thompsonjila/psoc_relocker/README.md

# psoc_relocker
PSoC-based PID Relocker with GUI
