thompsonjila/psoc_relocker/documentation/includes/relockerExtStructure.pdf

a) b)

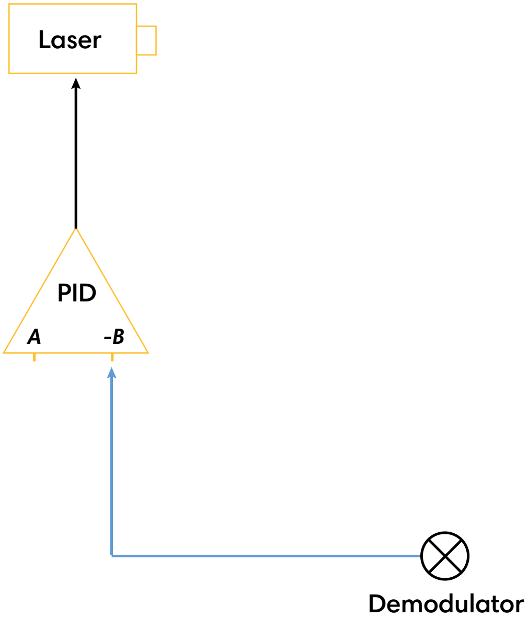
[picture p1: figure]
PID; Demodulator; Laser
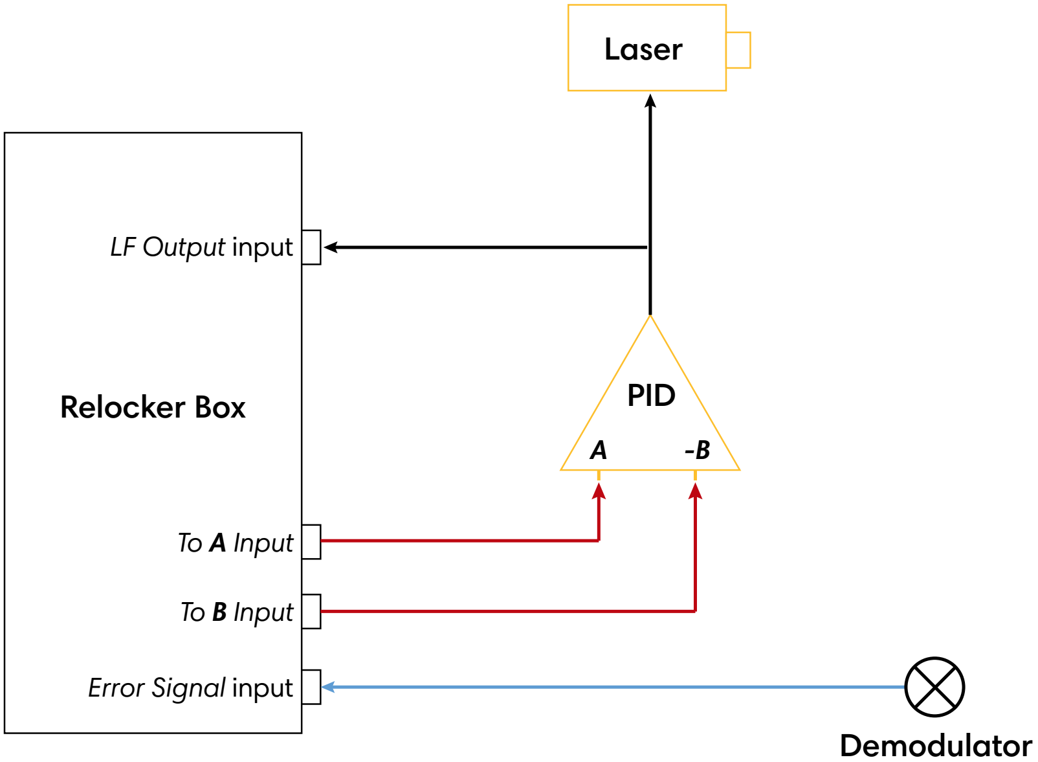
[picture p2: figure]
Error Signal input; To B Input; To A Input; LF Output input; Relocker Box; PID; Demodulator; Laser
