thompsonjila/psoc_relocker/documentation/includes/relockerSweepBoundCalculations.pdf

65535

-4 V | 0

255, 255

0, 0

4 V

Loop Filter Output Voltage | lfOutADC Parameters | DAC Parameters
