thompsonjila/psoc_relocker/documentation/includes/relockerBack.pdf

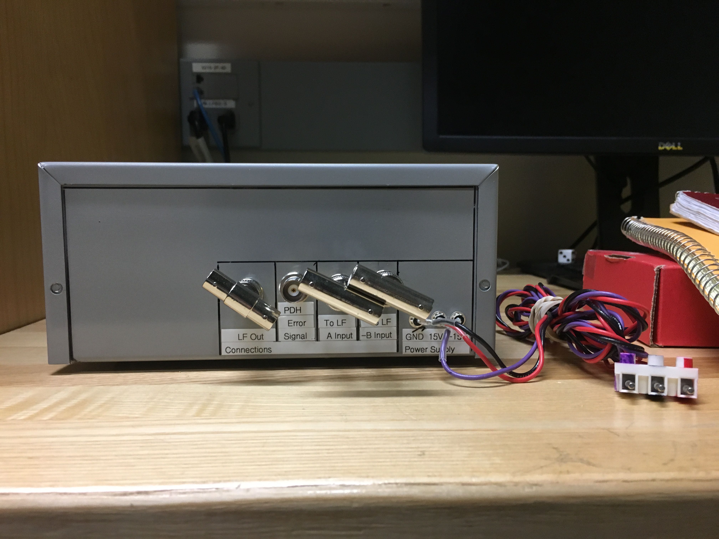
[picture p3: page 1]
