thompsonjila/psoc_relocker/documentation/includes/relockerFront.pdf

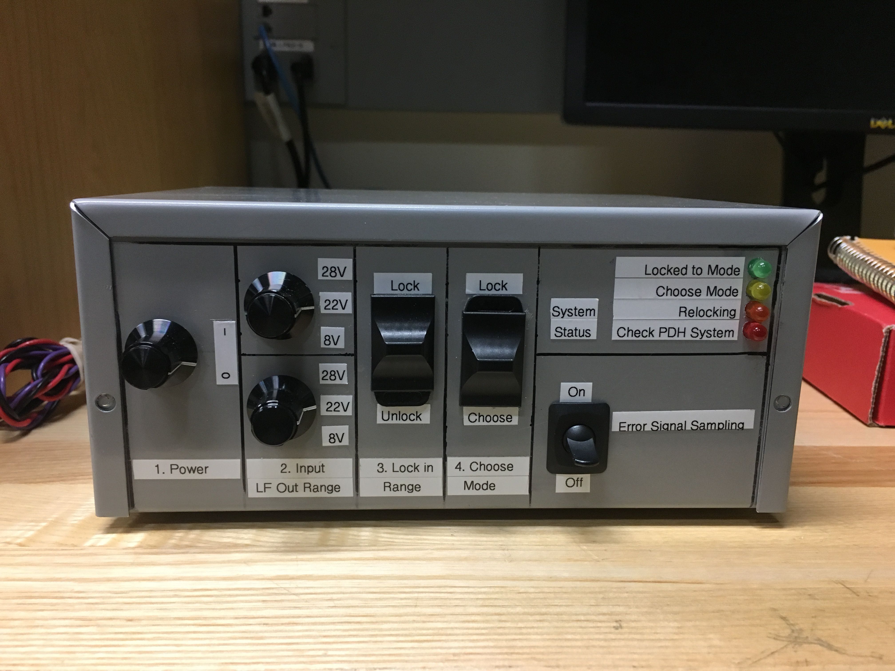
[picture p4: page 1]
