thompsonjila/psoc_relocker/documentation/includes/relockerInterior.pdf

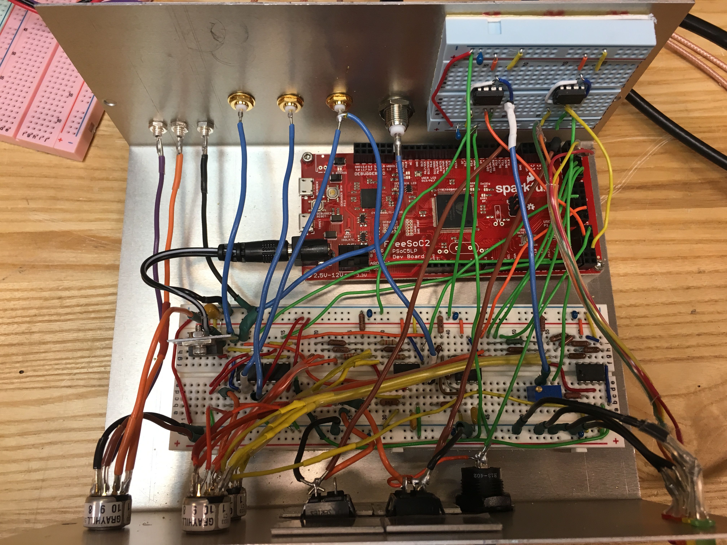
[picture p5: page 1]
