thompsonjila/psoc_relocker/documentation/includes/pinassignments.png

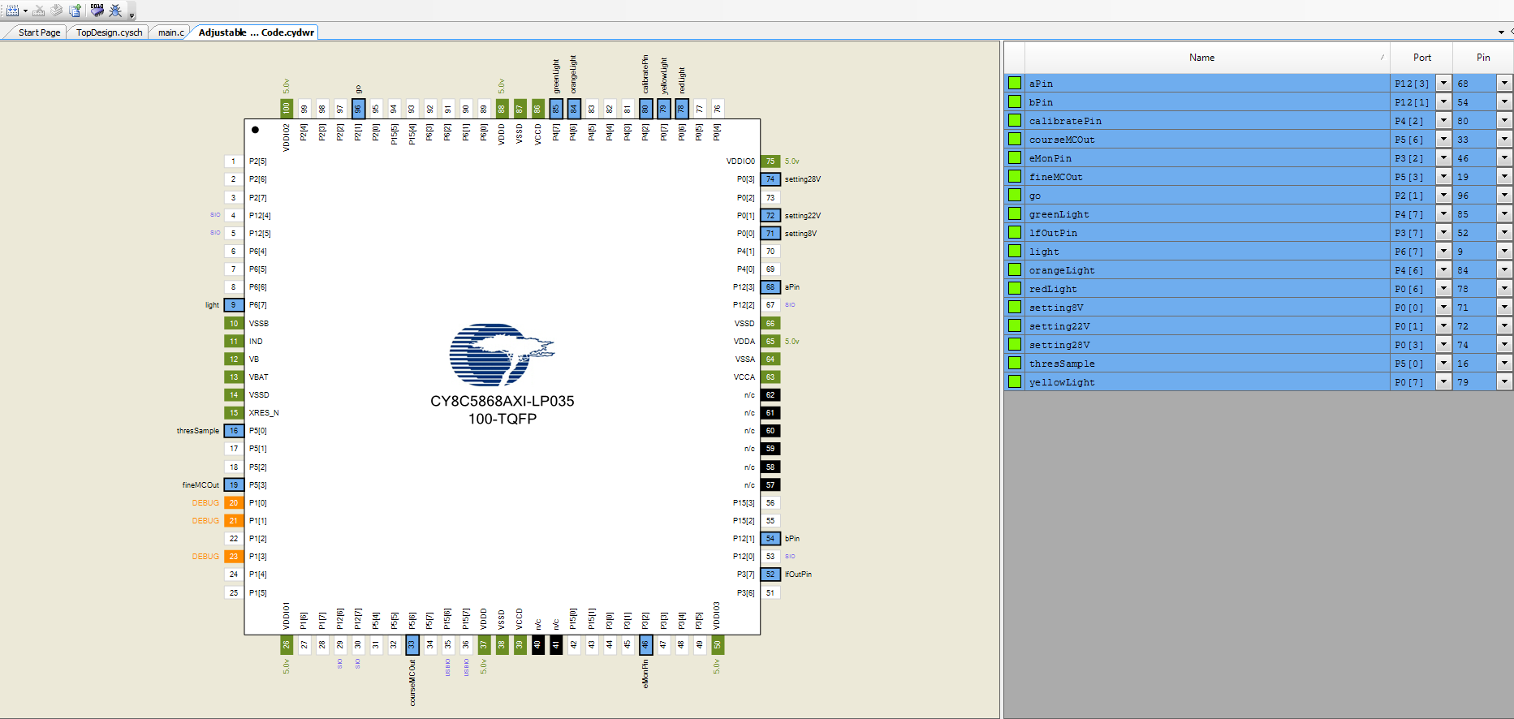
documentation/includes/pinassignments.png
