thompsonjila/psoc_relocker/documentation/includes/programmingIDE.png

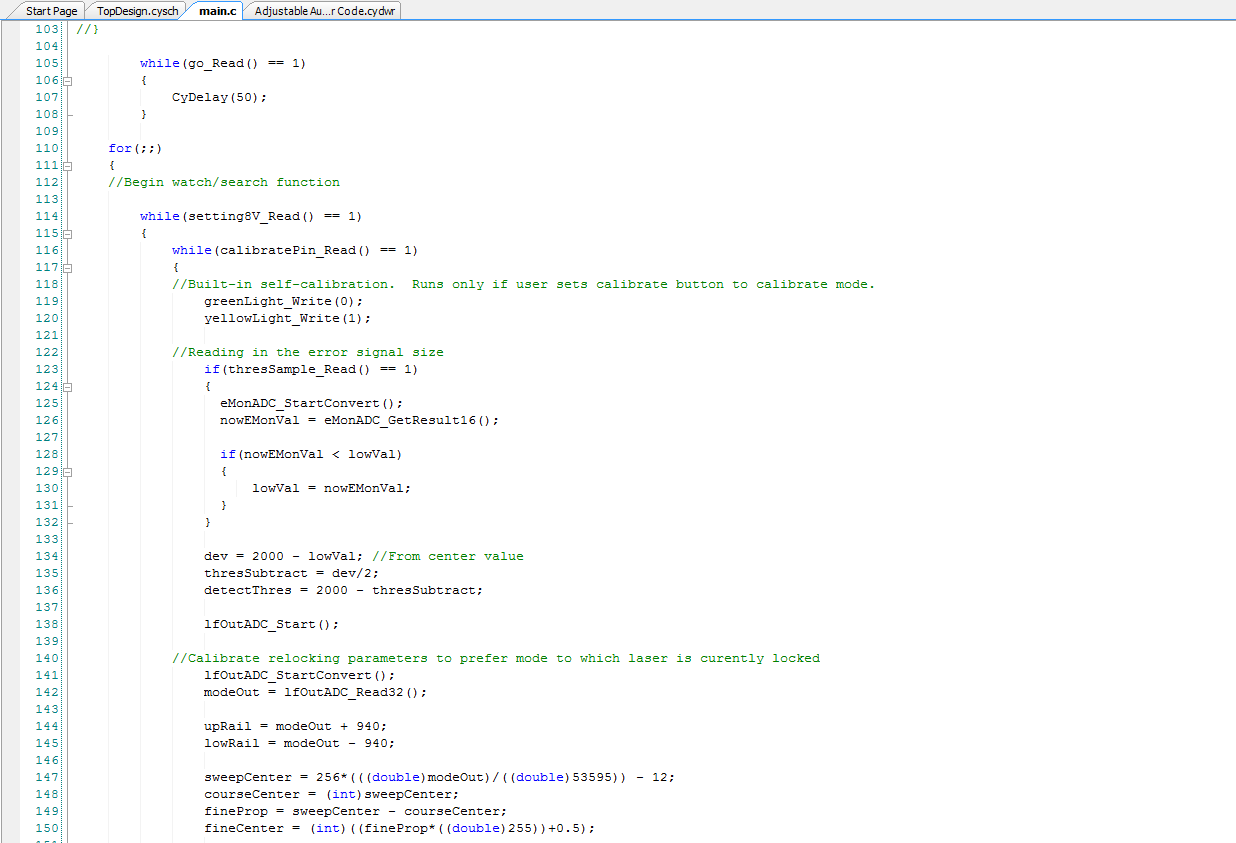
documentation/includes/programmingIDE.png
