thompsonjila/psoc_relocker/documentation/includes/relocker_circuits.png

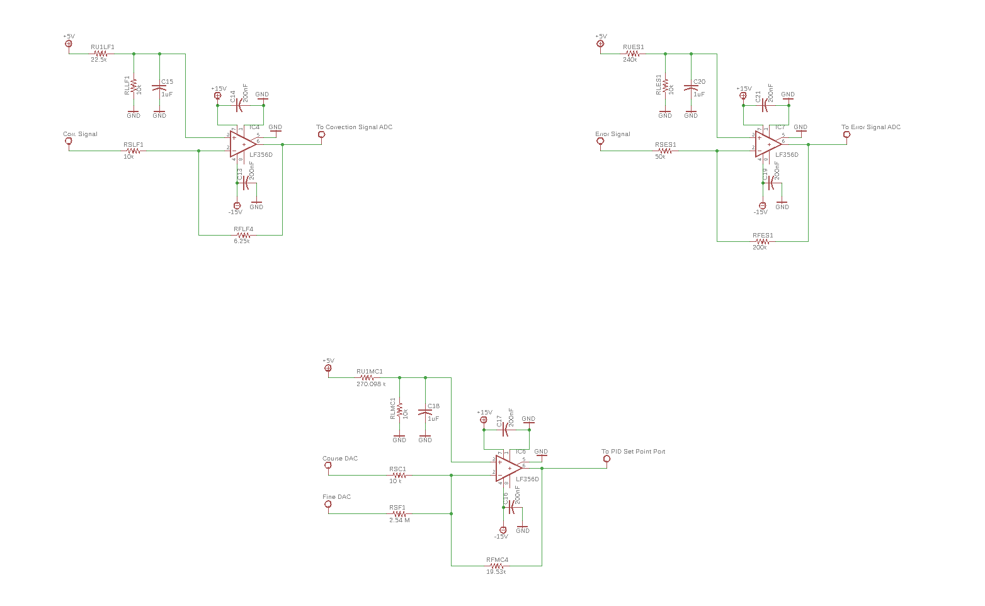
documentation/includes/relocker_circuits.png
