thompsonjila/psoc_relocker/documentation/includes/topdesign.png

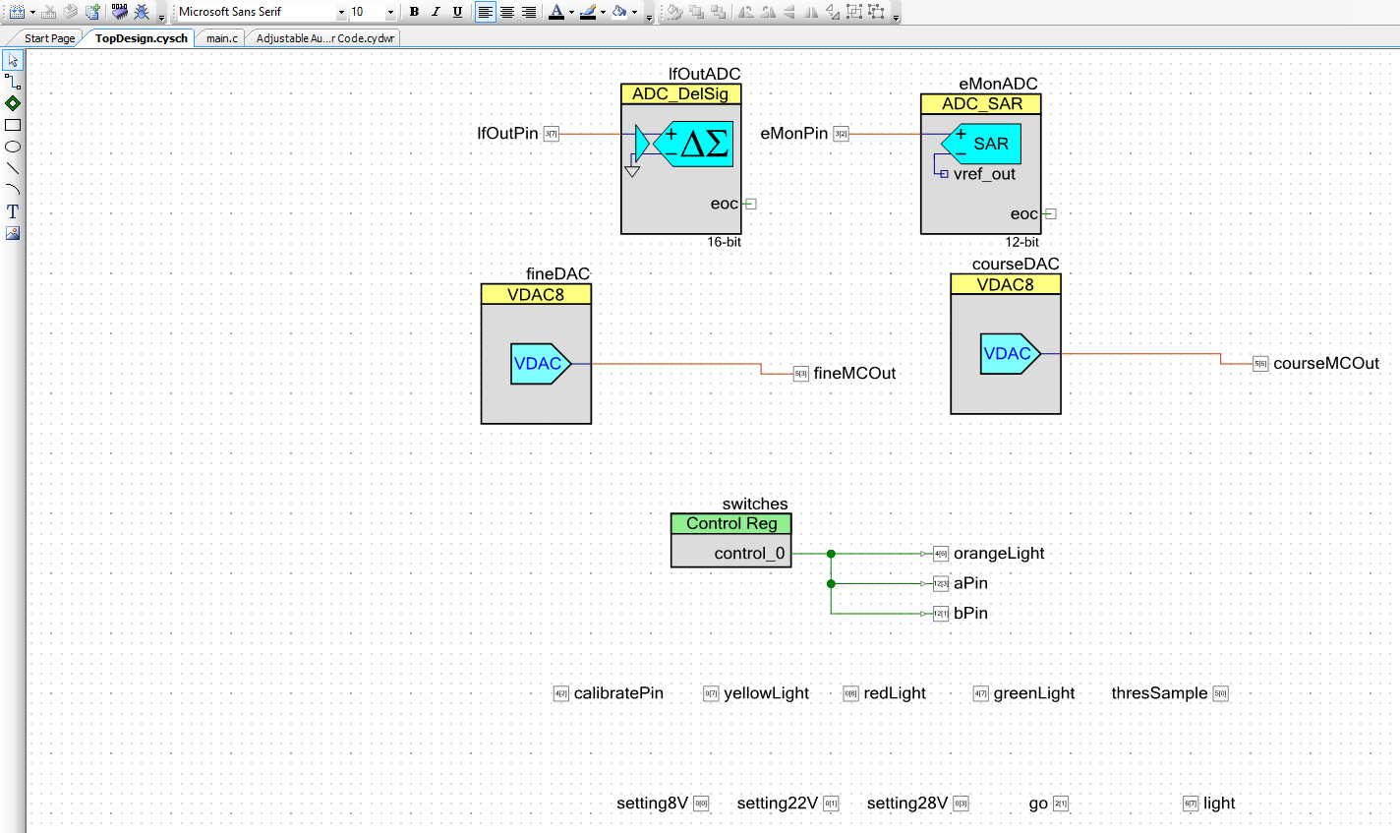
documentation/includes/topdesign.png
