thompsonjila/psoc_relocker/documentation/includes/relockerIntStructure.pdf

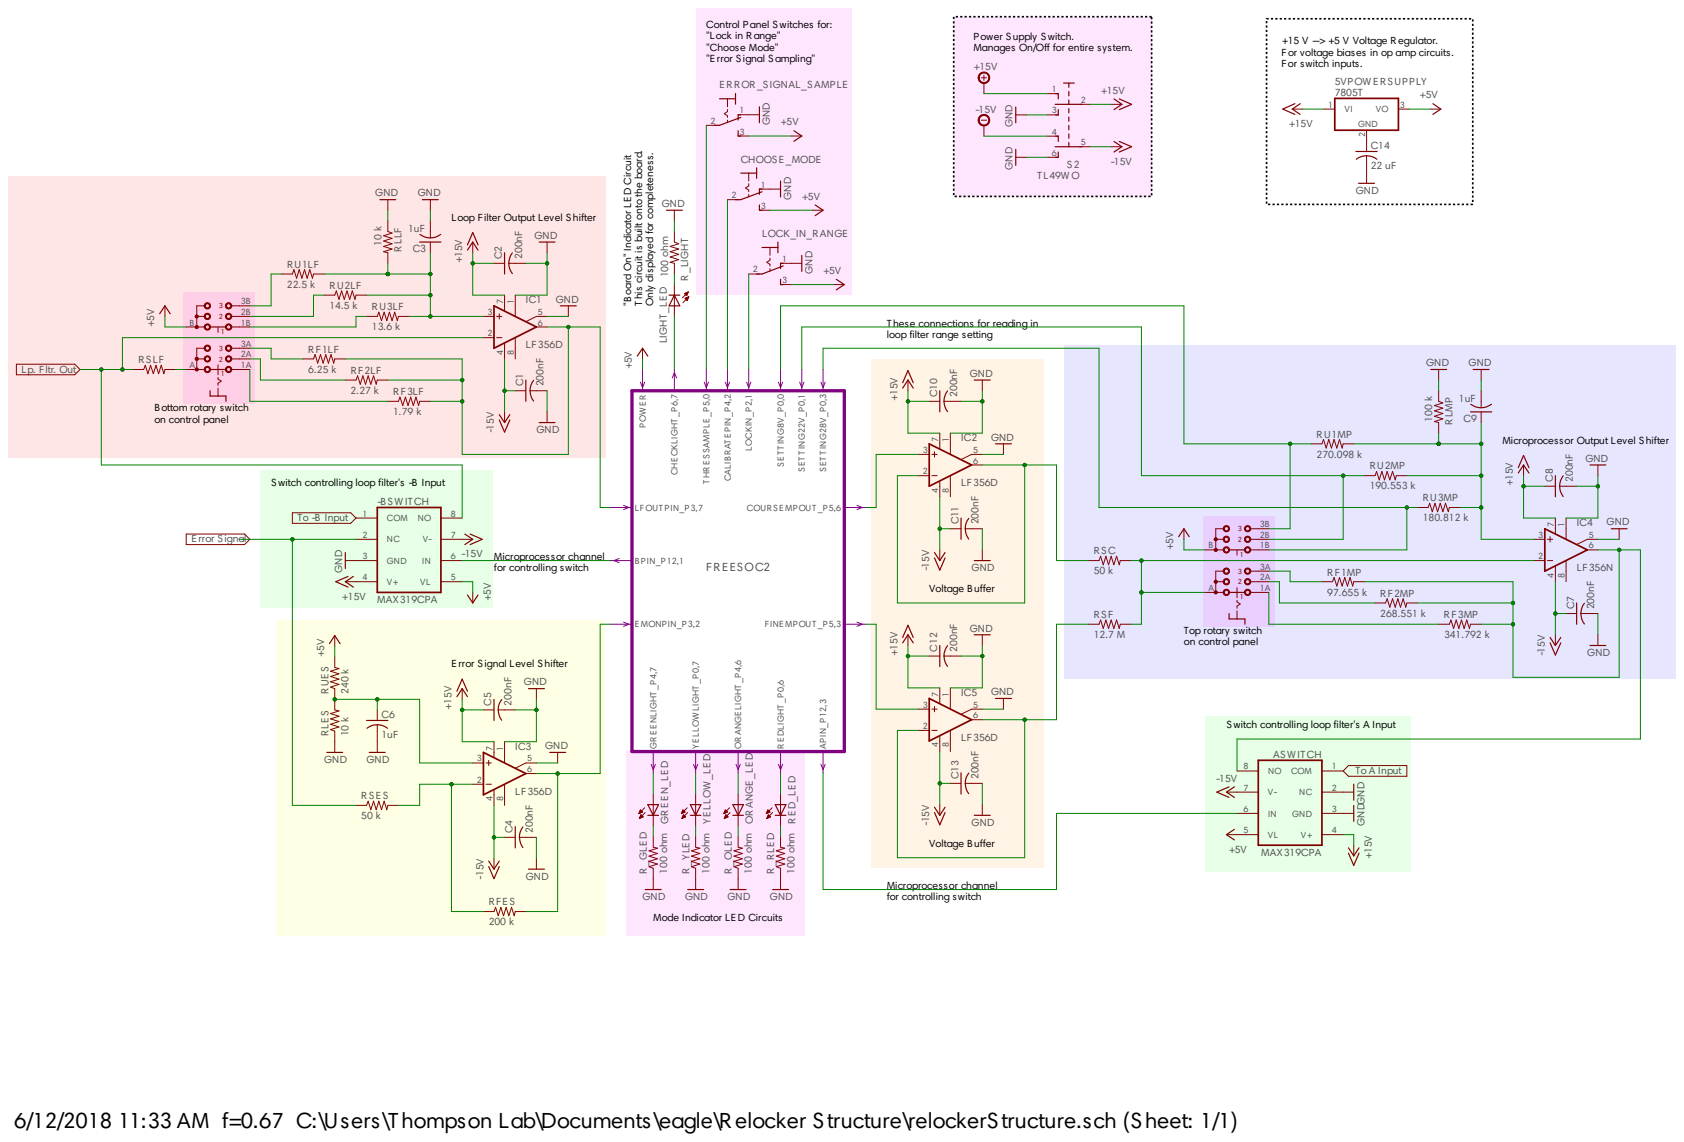
[picture p28: page 1]

Control Panel Switches for:
"Lock in R ange"
"Choose Mode"
"E rror Signal Sampling"

Power Supply Switch.
Manages On/Off for entire system.

+15 V --> +5 V Voltage R egulator.
For voltage biases in op amp circuits.
For switch inputs.

"Board On" Indicator LE D Circuit

T his circuit is built onto the board.

Only displayed for completeness. Mode Indicator LE D Circuits

GND
Loop Filter Output Level Shifter

T hese connections for reading in
loop filter range setting

Switch controlling loop filter's -B Input

E rror Signal Level Shifter

Switch controlling loop filter's A Input

6/12/2018 11:33 AM f=0.67 C:\Users\T hompson Lab\Documents\eagle\R elocker Structure\relockerStructure.sch (Sheet: 1/1)
