thompsonjila/psoc_relocker/documentation/includes/relocker_pcb_schematic.pdf

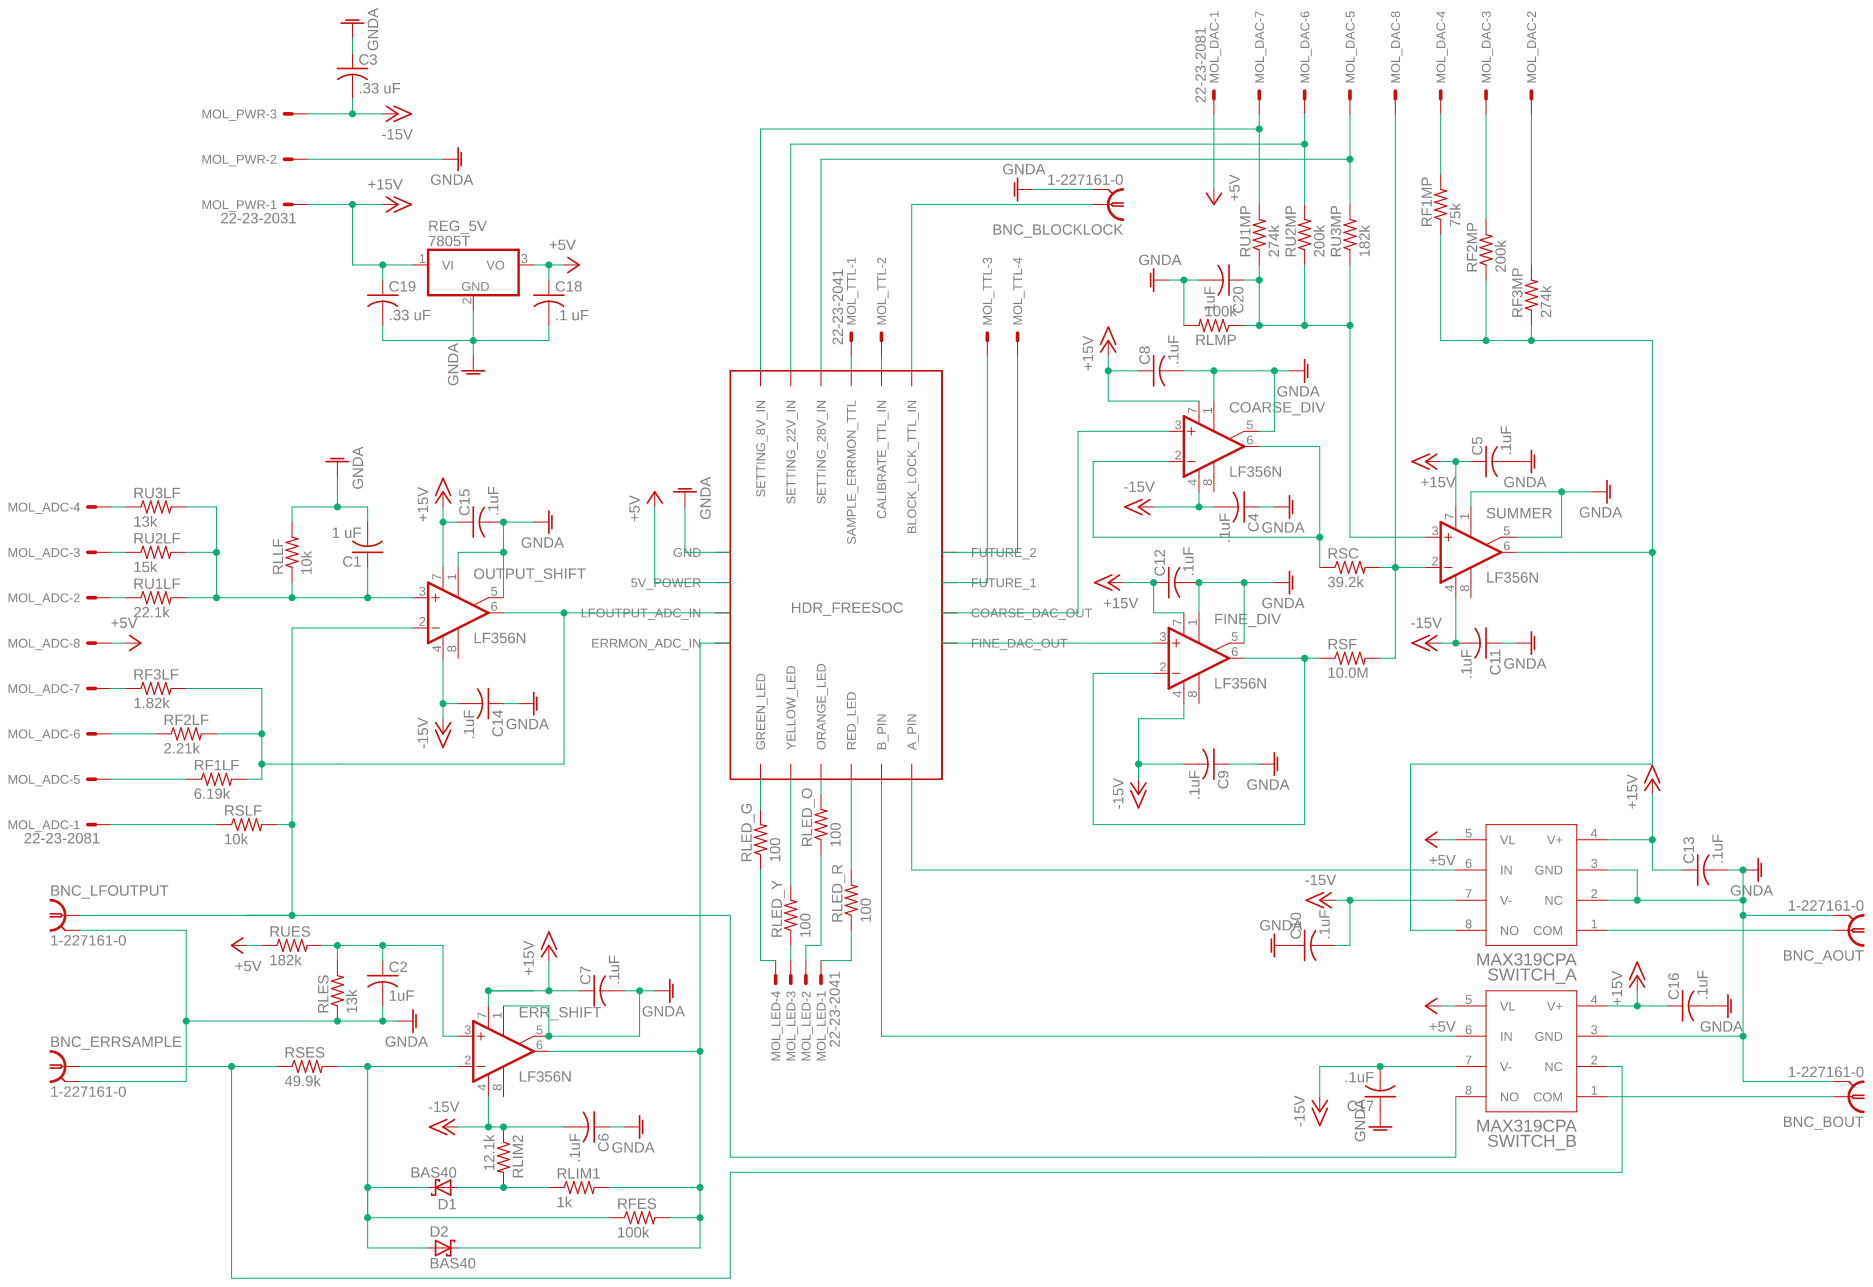
[picture p29: page 1]
