thompsonjila/psoc_relocker/documentation/includes/relocker_pcb_schematic_colored.pdf

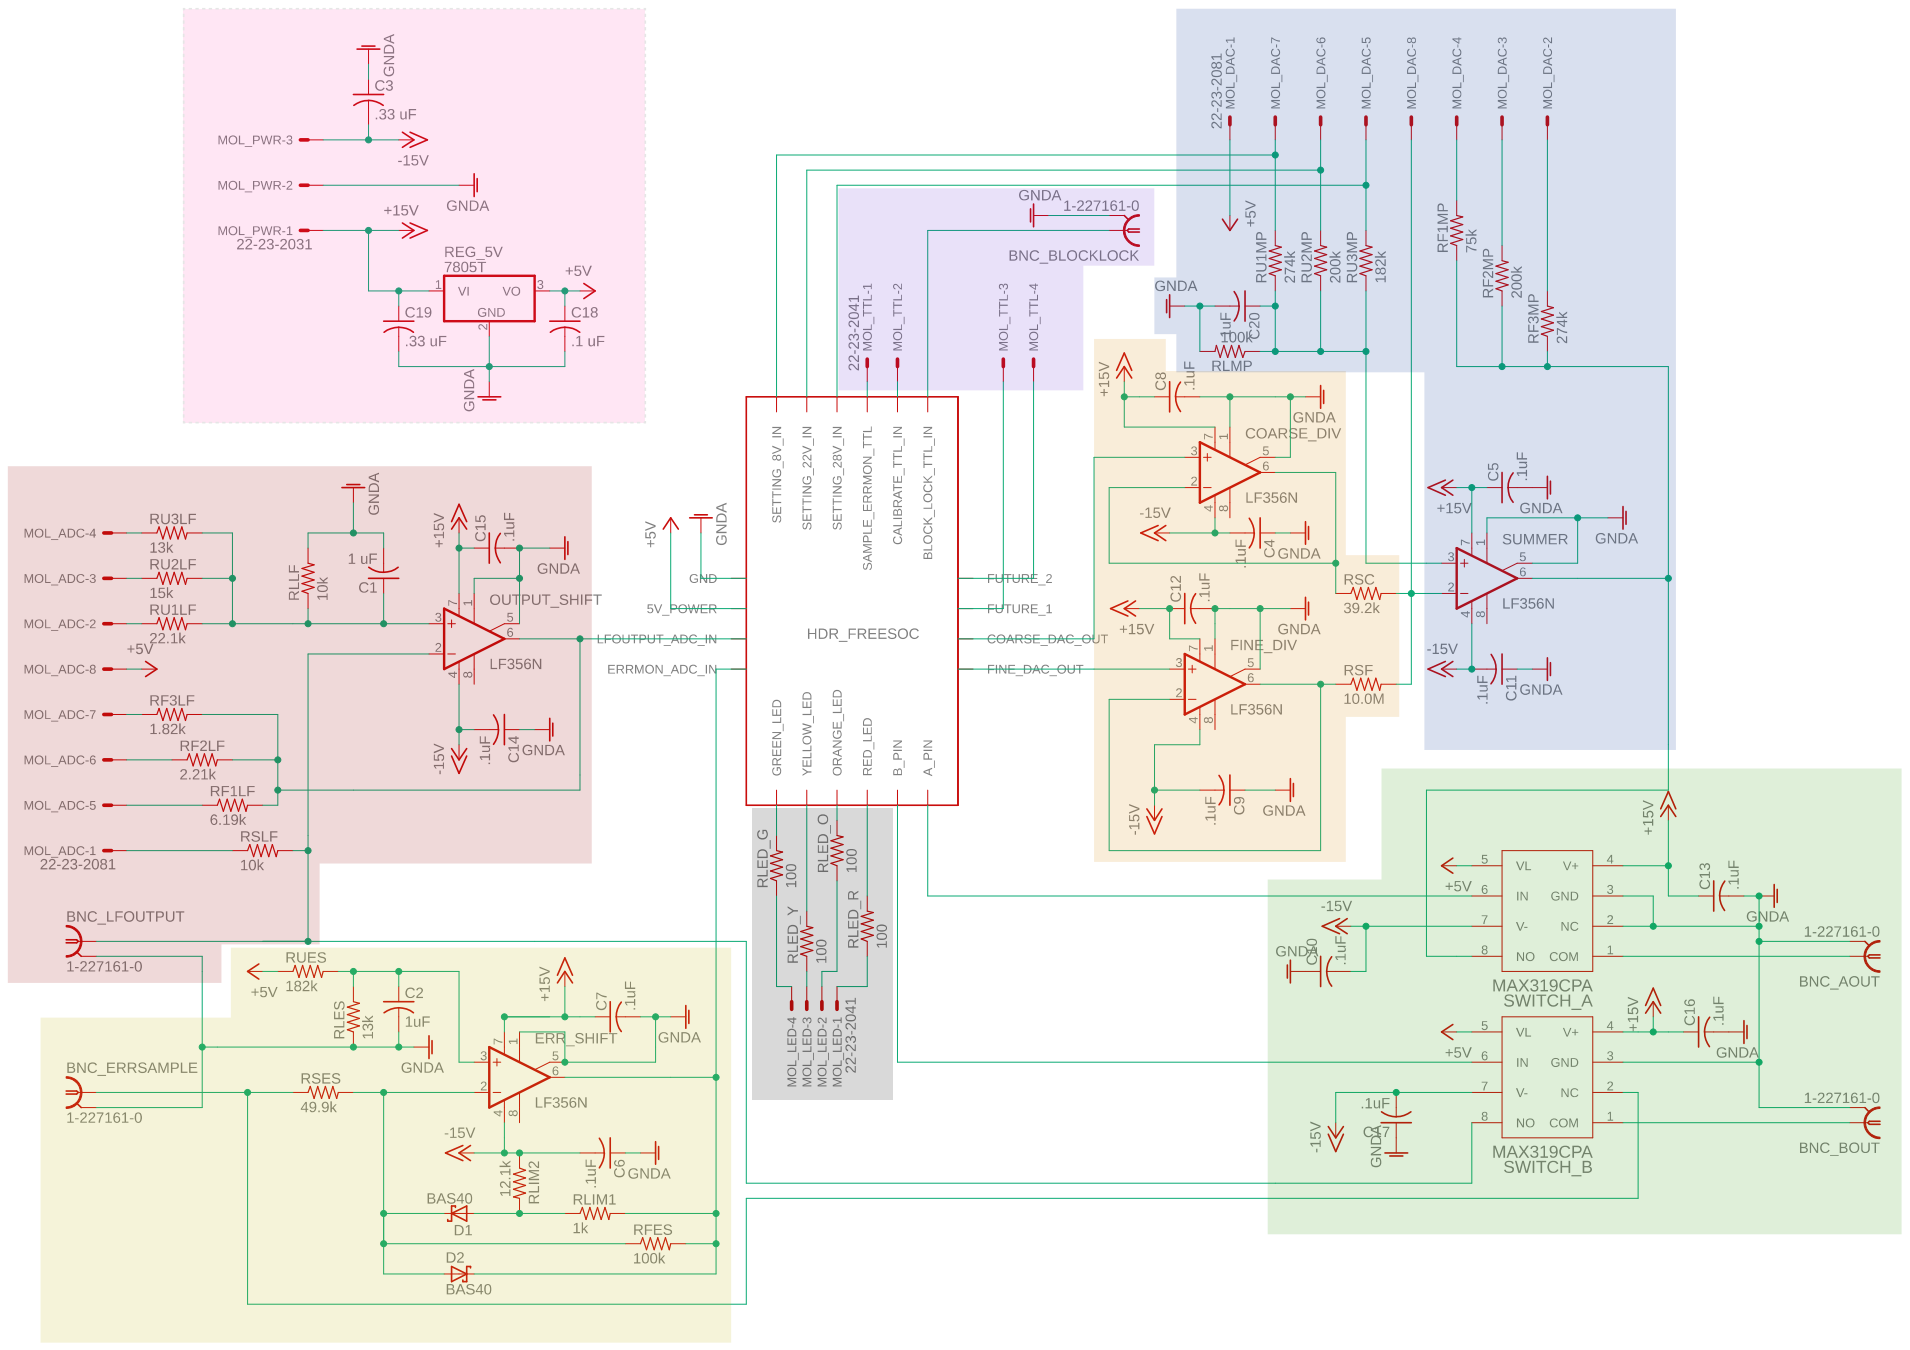
[picture p30: page 1]
