thompsonjila/psoc_relocker/documentation/includes/relocker_pcb_layout.pdf

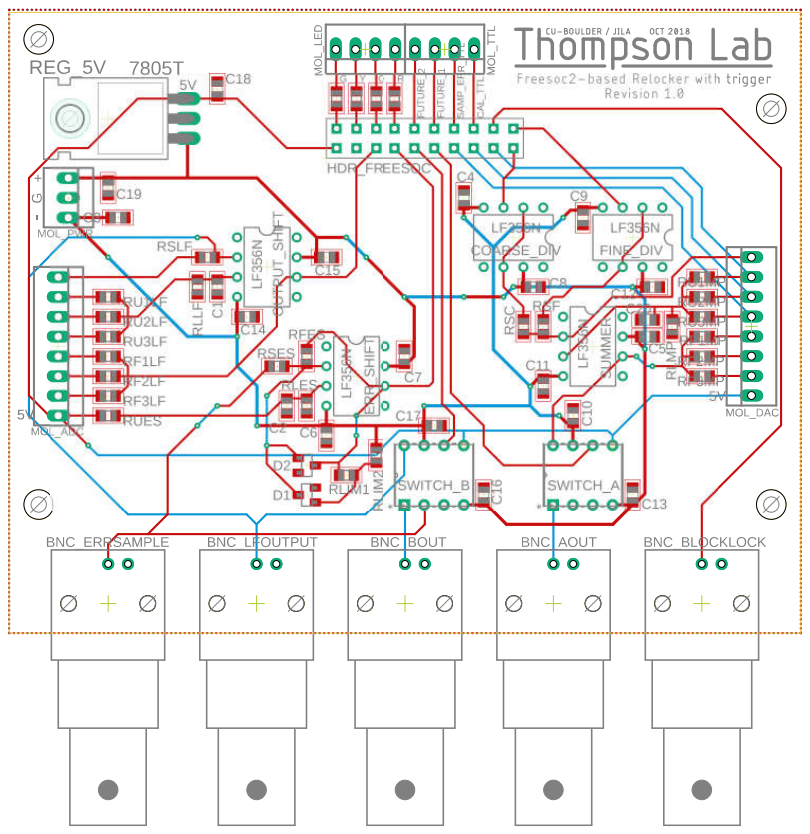
[picture p31: page 1]
