thompsonjila/psoc_relocker/pcb/relocker_schematic_cleaned.brd

## EAGLE design pcb/relocker_schematic_cleaned.brd (2019-09-17)

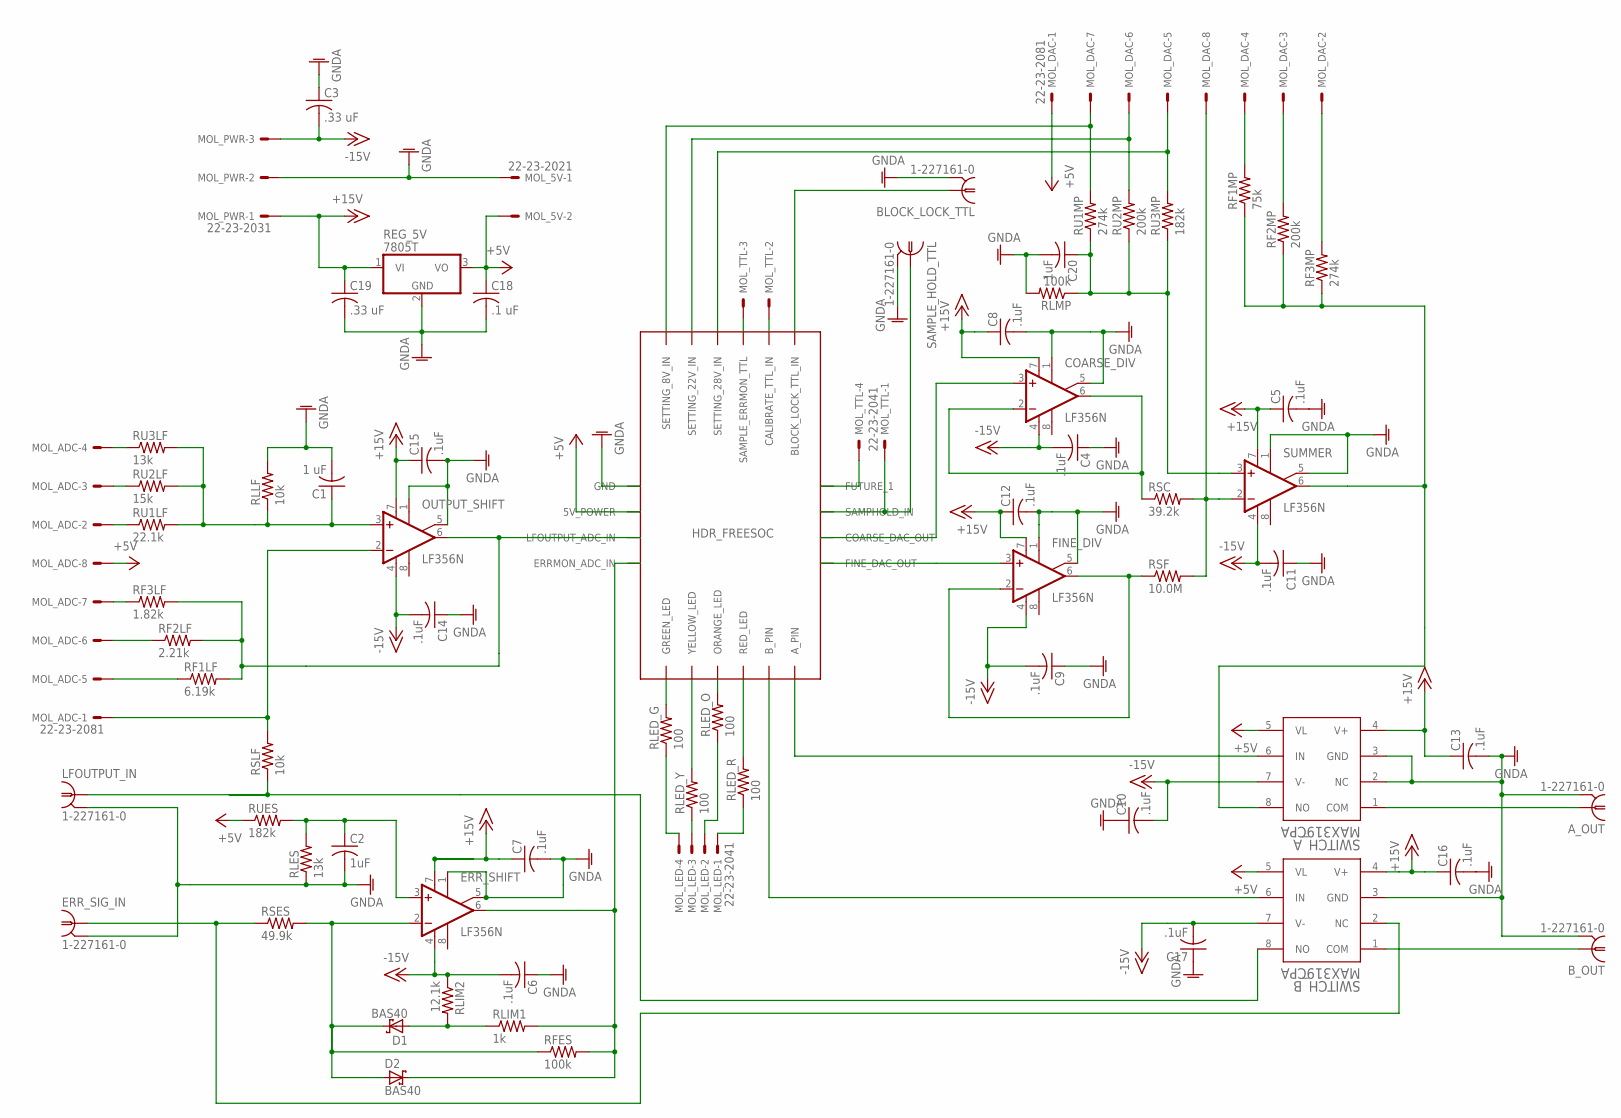
[picture p32: schematic relocker_schematic_cleaned.sch]

Parts:
A_OUT: 1-227161-0; AMP_227161
BLOCK_LOCK_TTL: 1-227161-0; AMP_227161
B_OUT: 1-227161-0; AMP_227161
C1: 1 uF; C0805
C2, C20: 1uF; C0805
C3, C19: .33 uF; C0805
C4, C5, C6, C7, C8, C9, C10, C11, C12, C13, C14, C15, C16, C17: .1uF; C0805
C18: .1 uF; C0805
COARSE_DIV: LF356N; DIL08
D1, D2: BAS40; SOT23
ERR_SHIFT: LF356N; DIL08
ERR_SIG_IN: 1-227161-0; AMP_227161
FINE_DIV: LF356N; DIL08
HDR_FREESOC: FREESOC2_BREAKOUT
LFOUTPUT_IN: 1-227161-0; AMP_227161
MOL_5V: 22-23-2021
MOL_ADC: 22-23-2081
MOL_DAC: 22-23-2081
MOL_LED: 22-23-2041
MOL_PWR: 22-23-2031
MOL_TTL: 22-23-2041
OUTPUT_SHIFT: LF356N; DIL08
REG_5V: 7805T; TO220H
RF1LF: 6.19k; R0805
RF1MP: 75k; R0805
RF2LF: 2.21k; R0805
RF2MP: 200k; R0805
RF3LF: 1.82k; R0805
RF3MP: 274k; R0805
RFES: 100k; R0805
RLED_G: 100; R0805
RLED_O: 100; R0805
RLED_R: 100; R0805
RLED_Y: 100; R0805
RLES: 13k; R0805
RLIM1: 1k; R0805
RLIM2: 12.1k; R0805
RLLF: 10k; R0805
RLMP: 100k; R0805
RSC: 39.2k; R0805
RSES: 49.9k; R0805
RSF: 10.0M; R0805
RSLF: 10k; R0805
RU1LF: 22.1k; R0805
RU1MP: 274k; R0805
RU2LF: 15k; R0805
RU2MP: 200k; R0805
RU3LF: 13k; R0805
RU3MP: 182k; R0805
RUES: 182k; R0805
SAMPLE_HOLD_TTL: 1-227161-0; AMP_227161
SUMMER: LF356N; DIL08
SWITCH_A: MAX319CPA; 21-0043D_8
SWITCH_B: MAX319CPA; 21-0043D_8

Connections:
+5V: C18.1, HDR_FREESOC.1 (5V_POWER), MOL_5V.2, MOL_ADC.8, MOL_DAC.1, REG_5V.3 (VO), RUES.1, SWITCH_A.5 (VL), SWITCH_B.5 (VL)
+15V: C5.1, C7.1, C8.1, C12.1, C13.1, C15.1, C16.1, C19.1, COARSE_DIV.7 (V+), ERR_SHIFT.7 (V+), FINE_DIV.7 (V+), MOL_PWR.1, OUTPUT_SHIFT.7 (V+), REG_5V.1 (VI), SUMMER.7 (V+), SWITCH_A.4 (V+), SWITCH_B.4 (V+)
-15V: C3.2, C4.2, C6.2, C9.2, C10.2, C11.2, C14.2, C17.2, COARSE_DIV.4 (V-), ERR_SHIFT.4 (V-), FINE_DIV.4 (V-), MOL_PWR.3, OUTPUT_SHIFT.4 (V-), RLIM2.1, SUMMER.4 (V-), SWITCH_A.7 (V-), SWITCH_B.7 (V-)
GNDA: A_OUT.2, BLOCK_LOCK_TTL.2, B_OUT.2, C1.2, C2.2, C3.1, C4.1, C5.2, C6.1, C7.2, C8.2, C9.1, C10.1, C11.1, C12.2, C13.2, C14.1, C15.2, C16.2, C17.1, C18.2, C19.2, C20.2, COARSE_DIV.1 (ON1), COARSE_DIV.5 (ON2), ERR_SHIFT.1 (ON1), ERR_SHIFT.5 (ON2), ERR_SIG_IN.2, FINE_DIV.1 (ON1), FINE_DIV.5 (ON2), HDR_FREESOC.2 (GND), LFOUTPUT_IN.2, MOL_5V.1, MOL_PWR.2, OUTPUT_SHIFT.1 (ON1), OUTPUT_SHIFT.5 (ON2), REG_5V.2 (GND), RLES.1, RLLF.2, RLMP.2, SAMPLE_HOLD_TTL.2, SUMMER.1 (ON1), SUMMER.5 (ON2), SWITCH_A.2 (NC), SWITCH_A.3 (GND), SWITCH_B.3 (GND)
unnamed: COARSE_DIV.3 (+IN), HDR_FREESOC.10 (COARSE_DAC_OUT)
unnamed: COARSE_DIV.2 (-IN), COARSE_DIV.6 (OUT), RSC.1
unnamed: MOL_DAC.4, RF1MP.2
unnamed: FINE_DIV.3 (+IN), HDR_FREESOC.11 (FINE_DAC_OUT)
unnamed: BLOCK_LOCK_TTL.1, HDR_FREESOC.12 (BLOCK_LOCK_TTL_IN)
unnamed: HDR_FREESOC.17 (RED_LED), RLED_R.2
unnamed: HDR_FREESOC.18 (ORANGE_LED), RLED_O.2
unnamed: HDR_FREESOC.19 (YELLOW_LED), RLED_Y.2
unnamed: HDR_FREESOC.20 (GREEN_LED), RLED_G.2
unnamed: MOL_LED.4, RLED_G.1
unnamed: MOL_LED.3, RLED_Y.1
unnamed: MOL_LED.2, RLED_O.1
unnamed: MOL_LED.1, RLED_R.1
unnamed: A_OUT.1, SWITCH_A.1 (COM)
unnamed: RF1MP.1, RF2MP.1, RF3MP.1, SUMMER.6 (OUT), SWITCH_A.8 (NO)
unnamed: HDR_FREESOC.6 (A_PIN), SWITCH_A.6 (IN)
unnamed: B_OUT.1, SWITCH_B.1 (COM)
unnamed: ERR_SIG_IN.1, RSES.1, SWITCH_B.2 (NC)
unnamed: HDR_FREESOC.9 (SETTING_8V_IN), MOL_DAC.7, RU1MP.2
unnamed: HDR_FREESOC.5 (B_PIN), SWITCH_B.6 (IN)
unnamed: LFOUTPUT_IN.1, RSLF.1, SWITCH_B.8 (NO)
unnamed: HDR_FREESOC.8 (SETTING_22V_IN), MOL_DAC.6, RU2MP.2
unnamed: HDR_FREESOC.7 (SETTING_28V_IN), MOL_DAC.5, RU3MP.2
unnamed: MOL_ADC.1, OUTPUT_SHIFT.2 (-IN), RSLF.2
unnamed: MOL_DAC.8, RSC.2, RSF.2, SUMMER.2 (-IN)
unnamed: FINE_DIV.2 (-IN), FINE_DIV.6 (OUT), RSF.1
unnamed: MOL_DAC.3, RF2MP.2
unnamed: MOL_DAC.2, RF3MP.2
unnamed: C20.1, RLMP.1, RU1MP.1, RU2MP.1, RU3MP.1, SUMMER.3 (+IN)
unnamed: HDR_FREESOC.3 (LFOUTPUT_ADC_IN), OUTPUT_SHIFT.6 (OUT), RF1LF.2, RF2LF.2, RF3LF.2
unnamed: MOL_ADC.5, RF1LF.1
unnamed: MOL_ADC.6, RF2LF.1
unnamed: MOL_ADC.7, RF3LF.1
unnamed: MOL_ADC.2, RU1LF.1
unnamed: MOL_ADC.3, RU2LF.1
unnamed: MOL_ADC.4, RU3LF.1
unnamed: C1.1, OUTPUT_SHIFT.3 (+IN), RLLF.1, RU1LF.2, RU2LF.2, RU3LF.2
unnamed: D1.3 (C), D2.1 (A), ERR_SHIFT.2 (-IN), RFES.1, RSES.2
unnamed: C2.1, ERR_SHIFT.3 (+IN), RLES.2, RUES.2
unnamed: D2.3 (C), ERR_SHIFT.6 (OUT), HDR_FREESOC.4 (ERRMON_ADC_IN), RFES.2, RLIM1.2
unnamed: HDR_FREESOC.16 (FUTURE_1), MOL_TTL.4
unnamed: HDR_FREESOC.13 (SAMPHOLD_IN), MOL_TTL.1, SAMPLE_HOLD_TTL.1
unnamed: HDR_FREESOC.14 (CALIBRATE_TTL_IN), MOL_TTL.2
unnamed: HDR_FREESOC.15 (SAMPLE_ERRMON_TTL), MOL_TTL.3
unnamed: D1.1 (A), RLIM1.1, RLIM2.2

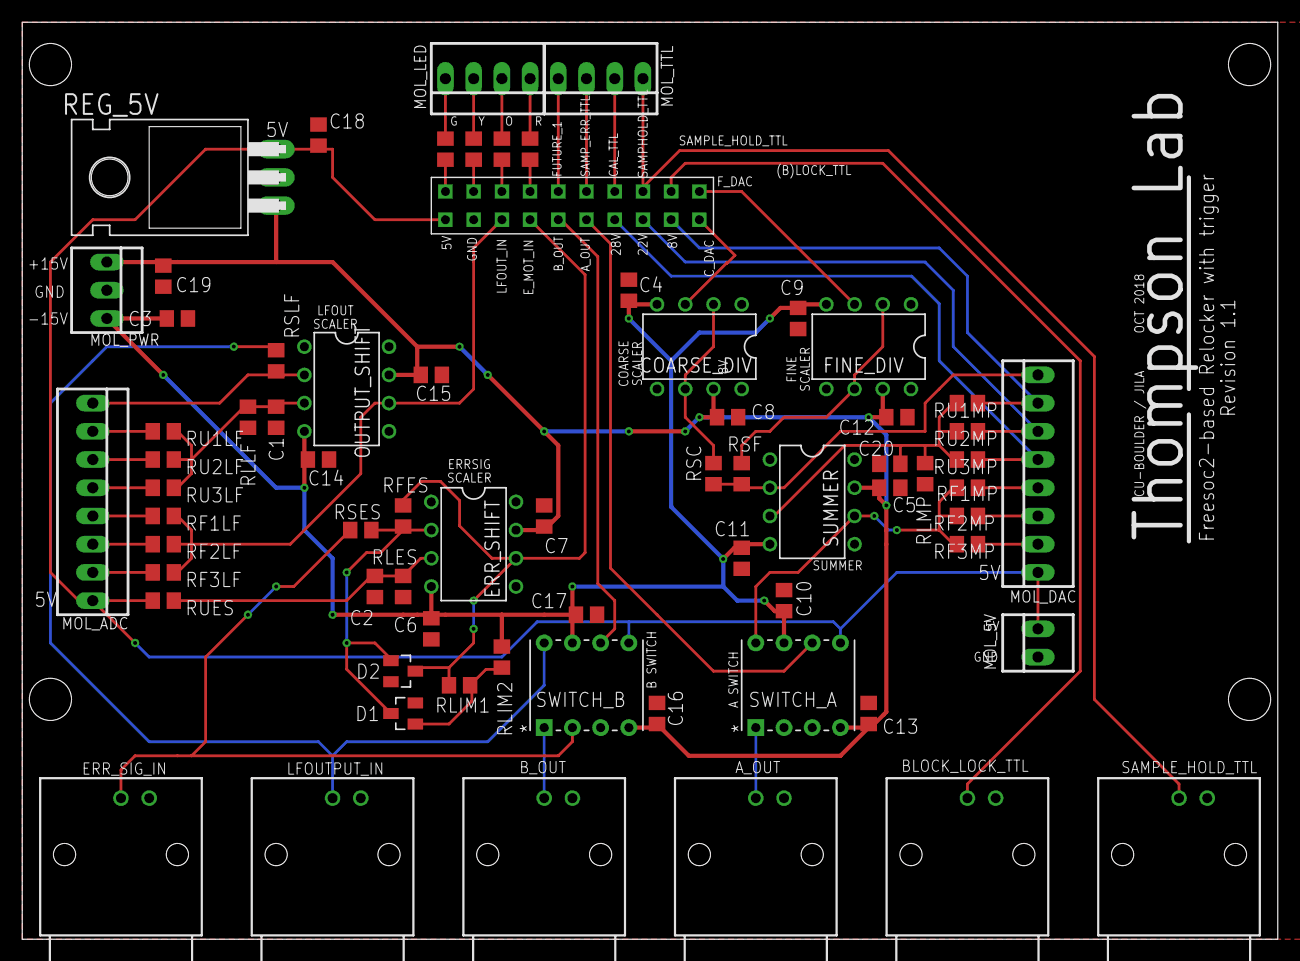
[picture p33: board relocker_schematic_cleaned.brd from above]

Board: 2 copper layers, 113.0 x 82.5 mm, 70 parts (0 on the bottom side), 49 nets.
