thompsonjila/psoc_relocker/src/Adjustable Automated Relocker Code.cydsn/codegentemp/LFOutADC_theACLK.h

/*******************************************************************************
* File Name: LFOutADC_theACLK.h
* Version 2.20
*
*  Description:
*   Provides the function and constant definitions for the clock component.
*
*  Note:
*
********************************************************************************
* Copyright 2008-2012, Cypress Semiconductor Corporation.  All rights reserved.
* You may use this file only in accordance with the license, terms, conditions, 
* disclaimers, and limitations in the end user license agreement accompanying 
* the software package with which this file was provided.
*******************************************************************************/

#if !defined(CY_CLOCK_LFOutADC_theACLK_H)
#define CY_CLOCK_LFOutADC_theACLK_H

#include <cytypes.h>
#include <cyfitter.h>


/***************************************
* Conditional Compilation Parameters
***************************************/

/* Check to see if required defines such as CY_PSOC5LP are available */
/* They are defined starting with cy_boot v3.0 */
#if !defined (CY_PSOC5LP)
    #error Component cy_clock_v2_20 requires cy_boot v3.0 or later
#endif /* (CY_PSOC5LP) */


/***************************************
*        Function Prototypes
***************************************/

void LFOutADC_theACLK_Start(void) ;
void LFOutADC_theACLK_Stop(void) ;

#if(CY_PSOC3 || CY_PSOC5LP)
void LFOutADC_theACLK_StopBlock(void) ;
#endif /* (CY_PSOC3 || CY_PSOC5LP) */

void LFOutADC_theACLK_StandbyPower(uint8 state) ;
void LFOutADC_theACLK_SetDividerRegister(uint16 clkDivider, uint8 restart) 
                                ;
uint16 LFOutADC_theACLK_GetDividerRegister(void) ;
void LFOutADC_theACLK_SetModeRegister(uint8 modeBitMask) ;
void LFOutADC_theACLK_ClearModeRegister(uint8 modeBitMask) ;
uint8 LFOutADC_theACLK_GetModeRegister(void) ;
void LFOutADC_theACLK_SetSourceRegister(uint8 clkSource) ;
uint8 LFOutADC_theACLK_GetSourceRegister(void) ;
#if defined(LFOutADC_theACLK__CFG3)
void LFOutADC_theACLK_SetPhaseRegister(uint8 clkPhase) ;
uint8 LFOutADC_theACLK_GetPhaseRegister(void) ;
#endif /* defined(LFOutADC_theACLK__CFG3) */

#define LFOutADC_theACLK_Enable()                       LFOutADC_theACLK_Start()
#define LFOutADC_theACLK_Disable()                      LFOutADC_theACLK_Stop()
#define LFOutADC_theACLK_SetDivider(clkDivider)         LFOutADC_theACLK_SetDividerRegister(clkDivider, 1u)
#define LFOutADC_theACLK_SetDividerValue(clkDivider)    LFOutADC_theACLK_SetDividerRegister((clkDivider) - 1u, 1u)
#define LFOutADC_theACLK_SetMode(clkMode)               LFOutADC_theACLK_SetModeRegister(clkMode)
#define LFOutADC_theACLK_SetSource(clkSource)           LFOutADC_theACLK_SetSourceRegister(clkSource)
#if defined(LFOutADC_theACLK__CFG3)
#define LFOutADC_theACLK_SetPhase(clkPhase)             LFOutADC_theACLK_SetPhaseRegister(clkPhase)
#define LFOutADC_theACLK_SetPhaseValue(clkPhase)        LFOutADC_theACLK_SetPhaseRegister((clkPhase) + 1u)
#endif /* defined(LFOutADC_theACLK__CFG3) */


/***************************************
*             Registers
***************************************/

/* Register to enable or disable the clock */
#define LFOutADC_theACLK_CLKEN              (* (reg8 *) LFOutADC_theACLK__PM_ACT_CFG)
#define LFOutADC_theACLK_CLKEN_PTR          ((reg8 *) LFOutADC_theACLK__PM_ACT_CFG)

/* Register to enable or disable the clock */
#define LFOutADC_theACLK_CLKSTBY            (* (reg8 *) LFOutADC_theACLK__PM_STBY_CFG)
#define LFOutADC_theACLK_CLKSTBY_PTR        ((reg8 *) LFOutADC_theACLK__PM_STBY_CFG)

/* Clock LSB divider configuration register. */
#define LFOutADC_theACLK_DIV_LSB            (* (reg8 *) LFOutADC_theACLK__CFG0)
#define LFOutADC_theACLK_DIV_LSB_PTR        ((reg8 *) LFOutADC_theACLK__CFG0)
#define LFOutADC_theACLK_DIV_PTR            ((reg16 *) LFOutADC_theACLK__CFG0)

/* Clock MSB divider configuration register. */
#define LFOutADC_theACLK_DIV_MSB            (* (reg8 *) LFOutADC_theACLK__CFG1)
#define LFOutADC_theACLK_DIV_MSB_PTR        ((reg8 *) LFOutADC_theACLK__CFG1)

/* Mode and source configuration register */
#define LFOutADC_theACLK_MOD_SRC            (* (reg8 *) LFOutADC_theACLK__CFG2)
#define LFOutADC_theACLK_MOD_SRC_PTR        ((reg8 *) LFOutADC_theACLK__CFG2)

#if defined(LFOutADC_theACLK__CFG3)
/* Analog clock phase configuration register */
#define LFOutADC_theACLK_PHASE              (* (reg8 *) LFOutADC_theACLK__CFG3)
#define LFOutADC_theACLK_PHASE_PTR          ((reg8 *) LFOutADC_theACLK__CFG3)
#endif /* defined(LFOutADC_theACLK__CFG3) */


/**************************************
*       Register Constants
**************************************/

/* Power manager register masks */
#define LFOutADC_theACLK_CLKEN_MASK         LFOutADC_theACLK__PM_ACT_MSK
#define LFOutADC_theACLK_CLKSTBY_MASK       LFOutADC_theACLK__PM_STBY_MSK

/* CFG2 field masks */
#define LFOutADC_theACLK_SRC_SEL_MSK        LFOutADC_theACLK__CFG2_SRC_SEL_MASK
#define LFOutADC_theACLK_MODE_MASK          (~(LFOutADC_theACLK_SRC_SEL_MSK))

#if defined(LFOutADC_theACLK__CFG3)
/* CFG3 phase mask */
#define LFOutADC_theACLK_PHASE_MASK         LFOutADC_theACLK__CFG3_PHASE_DLY_MASK
#endif /* defined(LFOutADC_theACLK__CFG3) */

#endif /* CY_CLOCK_LFOutADC_theACLK_H */


/* [] END OF FILE */
