thompsonjila/psoc_relocker/src/Adjustable Automated Relocker Code.cydsn/codegentemp/errMonADC_theACLK.h

/*******************************************************************************
* File Name: errMonADC_theACLK.h
* Version 2.20
*
*  Description:
*   Provides the function and constant definitions for the clock component.
*
*  Note:
*
********************************************************************************
* Copyright 2008-2012, Cypress Semiconductor Corporation.  All rights reserved.
* You may use this file only in accordance with the license, terms, conditions, 
* disclaimers, and limitations in the end user license agreement accompanying 
* the software package with which this file was provided.
*******************************************************************************/

#if !defined(CY_CLOCK_errMonADC_theACLK_H)
#define CY_CLOCK_errMonADC_theACLK_H

#include <cytypes.h>
#include <cyfitter.h>


/***************************************
* Conditional Compilation Parameters
***************************************/

/* Check to see if required defines such as CY_PSOC5LP are available */
/* They are defined starting with cy_boot v3.0 */
#if !defined (CY_PSOC5LP)
    #error Component cy_clock_v2_20 requires cy_boot v3.0 or later
#endif /* (CY_PSOC5LP) */


/***************************************
*        Function Prototypes
***************************************/

void errMonADC_theACLK_Start(void) ;
void errMonADC_theACLK_Stop(void) ;

#if(CY_PSOC3 || CY_PSOC5LP)
void errMonADC_theACLK_StopBlock(void) ;
#endif /* (CY_PSOC3 || CY_PSOC5LP) */

void errMonADC_theACLK_StandbyPower(uint8 state) ;
void errMonADC_theACLK_SetDividerRegister(uint16 clkDivider, uint8 restart) 
                                ;
uint16 errMonADC_theACLK_GetDividerRegister(void) ;
void errMonADC_theACLK_SetModeRegister(uint8 modeBitMask) ;
void errMonADC_theACLK_ClearModeRegister(uint8 modeBitMask) ;
uint8 errMonADC_theACLK_GetModeRegister(void) ;
void errMonADC_theACLK_SetSourceRegister(uint8 clkSource) ;
uint8 errMonADC_theACLK_GetSourceRegister(void) ;
#if defined(errMonADC_theACLK__CFG3)
void errMonADC_theACLK_SetPhaseRegister(uint8 clkPhase) ;
uint8 errMonADC_theACLK_GetPhaseRegister(void) ;
#endif /* defined(errMonADC_theACLK__CFG3) */

#define errMonADC_theACLK_Enable()                       errMonADC_theACLK_Start()
#define errMonADC_theACLK_Disable()                      errMonADC_theACLK_Stop()
#define errMonADC_theACLK_SetDivider(clkDivider)         errMonADC_theACLK_SetDividerRegister(clkDivider, 1u)
#define errMonADC_theACLK_SetDividerValue(clkDivider)    errMonADC_theACLK_SetDividerRegister((clkDivider) - 1u, 1u)
#define errMonADC_theACLK_SetMode(clkMode)               errMonADC_theACLK_SetModeRegister(clkMode)
#define errMonADC_theACLK_SetSource(clkSource)           errMonADC_theACLK_SetSourceRegister(clkSource)
#if defined(errMonADC_theACLK__CFG3)
#define errMonADC_theACLK_SetPhase(clkPhase)             errMonADC_theACLK_SetPhaseRegister(clkPhase)
#define errMonADC_theACLK_SetPhaseValue(clkPhase)        errMonADC_theACLK_SetPhaseRegister((clkPhase) + 1u)
#endif /* defined(errMonADC_theACLK__CFG3) */


/***************************************
*             Registers
***************************************/

/* Register to enable or disable the clock */
#define errMonADC_theACLK_CLKEN              (* (reg8 *) errMonADC_theACLK__PM_ACT_CFG)
#define errMonADC_theACLK_CLKEN_PTR          ((reg8 *) errMonADC_theACLK__PM_ACT_CFG)

/* Register to enable or disable the clock */
#define errMonADC_theACLK_CLKSTBY            (* (reg8 *) errMonADC_theACLK__PM_STBY_CFG)
#define errMonADC_theACLK_CLKSTBY_PTR        ((reg8 *) errMonADC_theACLK__PM_STBY_CFG)

/* Clock LSB divider configuration register. */
#define errMonADC_theACLK_DIV_LSB            (* (reg8 *) errMonADC_theACLK__CFG0)
#define errMonADC_theACLK_DIV_LSB_PTR        ((reg8 *) errMonADC_theACLK__CFG0)
#define errMonADC_theACLK_DIV_PTR            ((reg16 *) errMonADC_theACLK__CFG0)

/* Clock MSB divider configuration register. */
#define errMonADC_theACLK_DIV_MSB            (* (reg8 *) errMonADC_theACLK__CFG1)
#define errMonADC_theACLK_DIV_MSB_PTR        ((reg8 *) errMonADC_theACLK__CFG1)

/* Mode and source configuration register */
#define errMonADC_theACLK_MOD_SRC            (* (reg8 *) errMonADC_theACLK__CFG2)
#define errMonADC_theACLK_MOD_SRC_PTR        ((reg8 *) errMonADC_theACLK__CFG2)

#if defined(errMonADC_theACLK__CFG3)
/* Analog clock phase configuration register */
#define errMonADC_theACLK_PHASE              (* (reg8 *) errMonADC_theACLK__CFG3)
#define errMonADC_theACLK_PHASE_PTR          ((reg8 *) errMonADC_theACLK__CFG3)
#endif /* defined(errMonADC_theACLK__CFG3) */


/**************************************
*       Register Constants
**************************************/

/* Power manager register masks */
#define errMonADC_theACLK_CLKEN_MASK         errMonADC_theACLK__PM_ACT_MSK
#define errMonADC_theACLK_CLKSTBY_MASK       errMonADC_theACLK__PM_STBY_MSK

/* CFG2 field masks */
#define errMonADC_theACLK_SRC_SEL_MSK        errMonADC_theACLK__CFG2_SRC_SEL_MASK
#define errMonADC_theACLK_MODE_MASK          (~(errMonADC_theACLK_SRC_SEL_MSK))

#if defined(errMonADC_theACLK__CFG3)
/* CFG3 phase mask */
#define errMonADC_theACLK_PHASE_MASK         errMonADC_theACLK__CFG3_PHASE_DLY_MASK
#endif /* defined(errMonADC_theACLK__CFG3) */

#endif /* CY_CLOCK_errMonADC_theACLK_H */


/* [] END OF FILE */
