thompsonjila/psoc_relocker/src/Adjustable Automated Relocker Code.cydsn/codegentemp/switches_PM.c

/*******************************************************************************
* File Name: switches_PM.c
* Version 1.80
*
* Description:
*  This file contains the setup, control, and status commands to support 
*  the component operation in the low power mode. 
*
* Note:
*
********************************************************************************
* Copyright 2015, Cypress Semiconductor Corporation.  All rights reserved.
* You may use this file only in accordance with the license, terms, conditions, 
* disclaimers, and limitations in the end user license agreement accompanying 
* the software package with which this file was provided.
*******************************************************************************/

#include "switches.h"

/* Check for removal by optimization */
#if !defined(switches_Sync_ctrl_reg__REMOVED)

static switches_BACKUP_STRUCT  switches_backup = {0u};

    
/*******************************************************************************
* Function Name: switches_SaveConfig
********************************************************************************
*
* Summary:
*  Saves the control register value.
*
* Parameters:
*  None
*
* Return:
*  None
*
*******************************************************************************/
void switches_SaveConfig(void) 
{
    switches_backup.controlState = switches_Control;
}


/*******************************************************************************
* Function Name: switches_RestoreConfig
********************************************************************************
*
* Summary:
*  Restores the control register value.
*
* Parameters:
*  None
*
* Return:
*  None
*
*
*******************************************************************************/
void switches_RestoreConfig(void) 
{
     switches_Control = switches_backup.controlState;
}


/*******************************************************************************
* Function Name: switches_Sleep
********************************************************************************
*
* Summary:
*  Prepares the component for entering the low power mode.
*
* Parameters:
*  None
*
* Return:
*  None
*
*******************************************************************************/
void switches_Sleep(void) 
{
    switches_SaveConfig();
}


/*******************************************************************************
* Function Name: switches_Wakeup
********************************************************************************
*
* Summary:
*  Restores the component after waking up from the low power mode.
*
* Parameters:
*  None
*
* Return:
*  None
*
*******************************************************************************/
void switches_Wakeup(void)  
{
    switches_RestoreConfig();
}

#endif /* End check for removal by optimization */


/* [] END OF FILE */
