thompsonjila/psoc_relocker/src/Adjustable Automated Relocker Code.cydsn/codegentemp/sampleErrorMonitor.h

/*******************************************************************************
* File Name: sampleErrorMonitor.h  
* Version 2.20
*
* Description:
*  This file contains Pin function prototypes and register defines
*
* Note:
*
********************************************************************************
* Copyright 2008-2015, Cypress Semiconductor Corporation.  All rights reserved.
* You may use this file only in accordance with the license, terms, conditions, 
* disclaimers, and limitations in the end user license agreement accompanying 
* the software package with which this file was provided.
*******************************************************************************/

#if !defined(CY_PINS_sampleErrorMonitor_H) /* Pins sampleErrorMonitor_H */
#define CY_PINS_sampleErrorMonitor_H

#include "cytypes.h"
#include "cyfitter.h"
#include "cypins.h"
#include "sampleErrorMonitor_aliases.h"

/* APIs are not generated for P15[7:6] */
#if !(CY_PSOC5A &&\
	 sampleErrorMonitor__PORT == 15 && ((sampleErrorMonitor__MASK & 0xC0) != 0))


/***************************************
*        Function Prototypes             
***************************************/    

/**
* \addtogroup group_general
* @{
*/
void    sampleErrorMonitor_Write(uint8 value);
void    sampleErrorMonitor_SetDriveMode(uint8 mode);
uint8   sampleErrorMonitor_ReadDataReg(void);
uint8   sampleErrorMonitor_Read(void);
void    sampleErrorMonitor_SetInterruptMode(uint16 position, uint16 mode);
uint8   sampleErrorMonitor_ClearInterrupt(void);
/** @} general */

/***************************************
*           API Constants        
***************************************/
/**
* \addtogroup group_constants
* @{
*/
    /** \addtogroup driveMode Drive mode constants
     * \brief Constants to be passed as "mode" parameter in the sampleErrorMonitor_SetDriveMode() function.
     *  @{
     */
        #define sampleErrorMonitor_DM_ALG_HIZ         PIN_DM_ALG_HIZ
        #define sampleErrorMonitor_DM_DIG_HIZ         PIN_DM_DIG_HIZ
        #define sampleErrorMonitor_DM_RES_UP          PIN_DM_RES_UP
        #define sampleErrorMonitor_DM_RES_DWN         PIN_DM_RES_DWN
        #define sampleErrorMonitor_DM_OD_LO           PIN_DM_OD_LO
        #define sampleErrorMonitor_DM_OD_HI           PIN_DM_OD_HI
        #define sampleErrorMonitor_DM_STRONG          PIN_DM_STRONG
        #define sampleErrorMonitor_DM_RES_UPDWN       PIN_DM_RES_UPDWN
    /** @} driveMode */
/** @} group_constants */
    
/* Digital Port Constants */
#define sampleErrorMonitor_MASK               sampleErrorMonitor__MASK
#define sampleErrorMonitor_SHIFT              sampleErrorMonitor__SHIFT
#define sampleErrorMonitor_WIDTH              1u

/* Interrupt constants */
#if defined(sampleErrorMonitor__INTSTAT)
/**
* \addtogroup group_constants
* @{
*/
    /** \addtogroup intrMode Interrupt constants
     * \brief Constants to be passed as "mode" parameter in sampleErrorMonitor_SetInterruptMode() function.
     *  @{
     */
        #define sampleErrorMonitor_INTR_NONE      (uint16)(0x0000u)
        #define sampleErrorMonitor_INTR_RISING    (uint16)(0x0001u)
        #define sampleErrorMonitor_INTR_FALLING   (uint16)(0x0002u)
        #define sampleErrorMonitor_INTR_BOTH      (uint16)(0x0003u) 
    /** @} intrMode */
/** @} group_constants */

    #define sampleErrorMonitor_INTR_MASK      (0x01u) 
#endif /* (sampleErrorMonitor__INTSTAT) */


/***************************************
*             Registers        
***************************************/
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
