thompsonjila/psoc_relocker/(commit log)

2019-09-17 add psoc files, documentation
    [Adjustable Automated Relocker Code.sdf, relocker_schematic.brd, relocker_schematic.sch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]
2021-01-19 latest updates
    [Adjustable Automated Relocker Code.sdf]
